rooster-ninja/moon-temp-tracer/CAD/ADS1115IDGSR/DGS0010A.stp

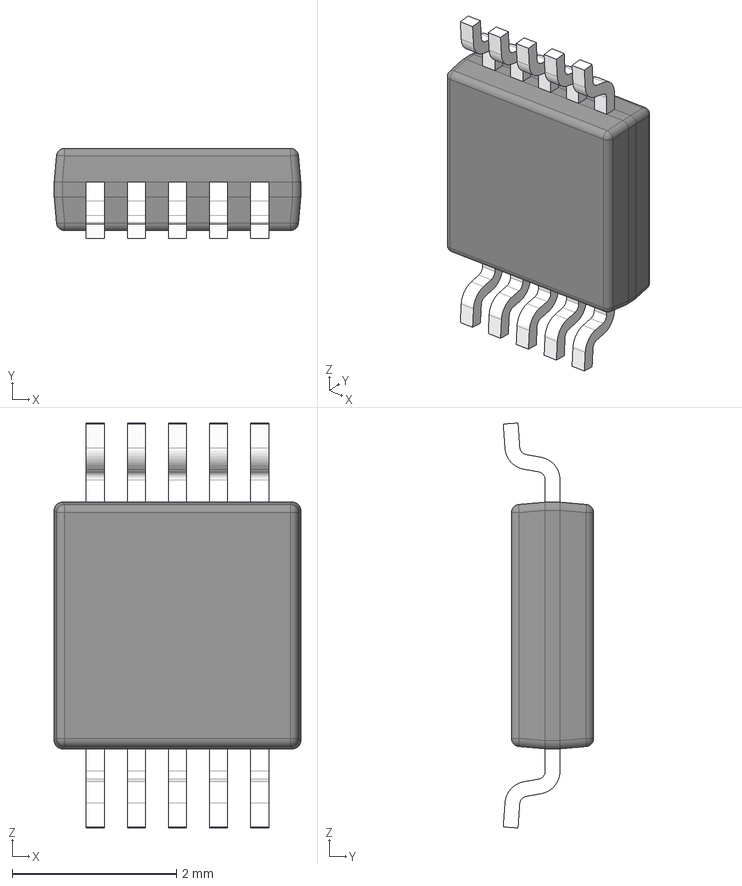
[picture p1: CAD file, 2026-07-23]
CAD/ADS1115IDGSR/DGS0010A.stp
3.00 x 1.10 x 4.93 mm
BODY-SO
LEAD-SO x 10
PIN1-ID
