rooster-ninja/moon-temp-tracer/CAD/KiCADv6/STP/CL05B104KP5VPNC.step

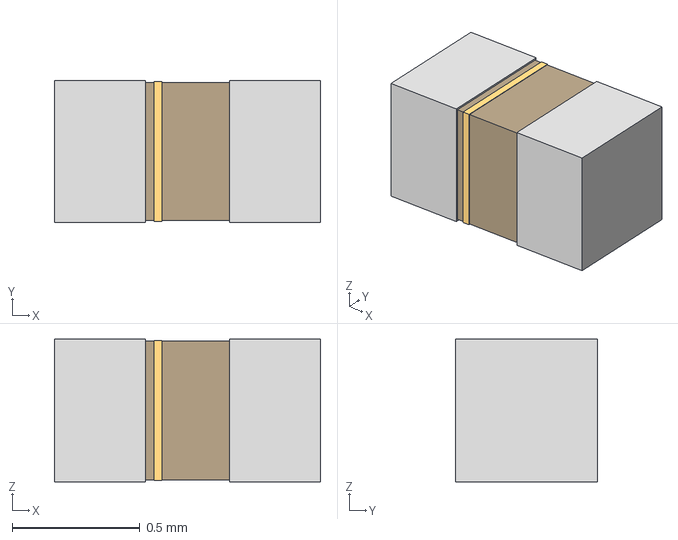
[picture p2: CAD file, 2026-07-25]
CAD/KiCADv6/STP/CL05B104KP5VPNC.step
1.04 x 0.558 x 0.559 mm
