rooster-ninja/moon-temp-tracer/CAD/RNCF0603TKY10K0/STA_RNCF0603_STP.step

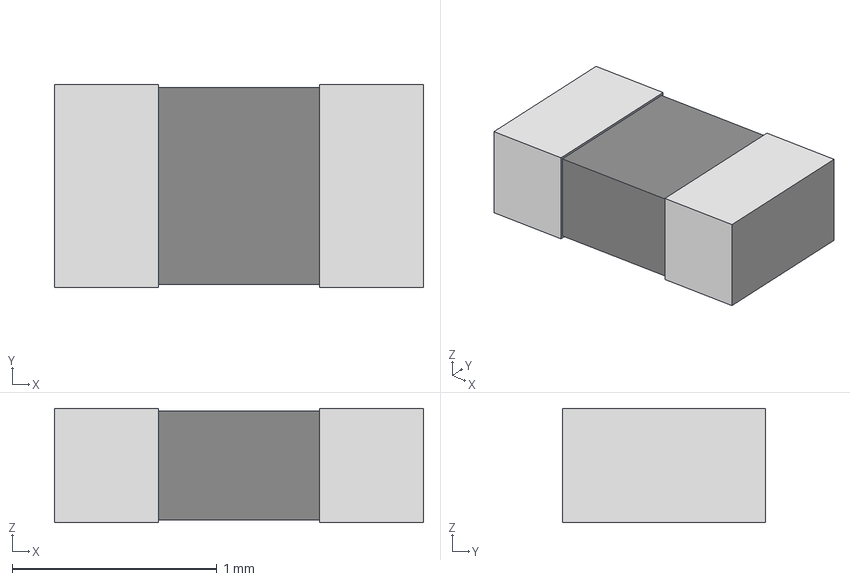
[picture p3: CAD file, 2026-07-23]
CAD/RNCF0603TKY10K0/STA_RNCF0603_STP.step
1.80 x 0.99 x 0.559 mm
