rooster-ninja/moon-temp-tracer/CAD/s861.stp

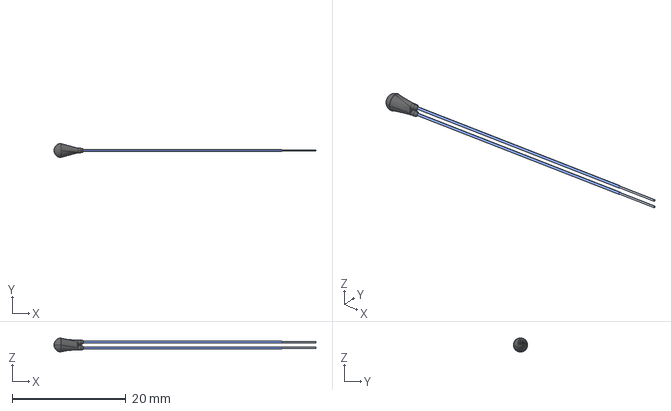
[picture p4: CAD file, 2026-07-23]
CAD/s861.stp
46.0 x 2.50 x 2.50 mm
