rooster-ninja/moon-temp-tracer/CAD/KiCADv6/STP/RC0402FR-074K7L.step

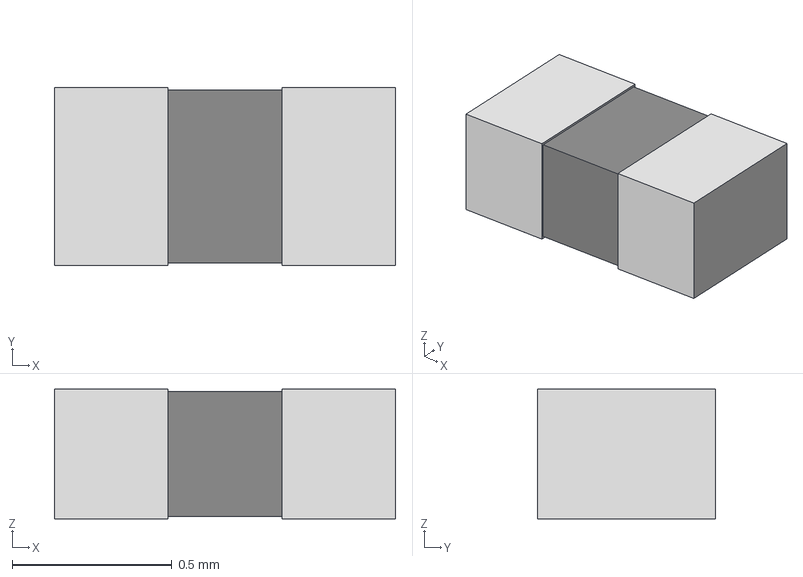
[picture p5: CAD file, 2026-07-25]
CAD/KiCADv6/STP/RC0402FR-074K7L.step
1.07 x 0.558 x 0.406 mm
