rooster-ninja/moon-temp-tracer/CAD/KiCADv6/STP/DBZ0003A.stp

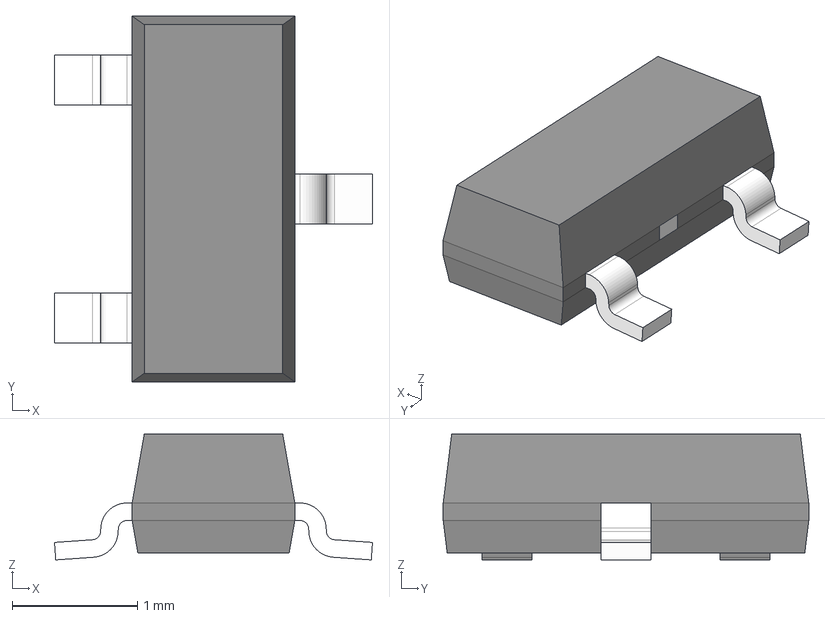
[picture p6: CAD file, 2026-07-25]
CAD/KiCADv6/STP/DBZ0003A.stp
2.54 x 2.92 x 1.01 mm
BODY-SOT
LEAD-SOT x 3
PIN1-ID
TIEBAR
