rooster-ninja/moon-temp-tracer/CAD/KiCADv6/STP/CAP_GRM155R60J106ME05D.step

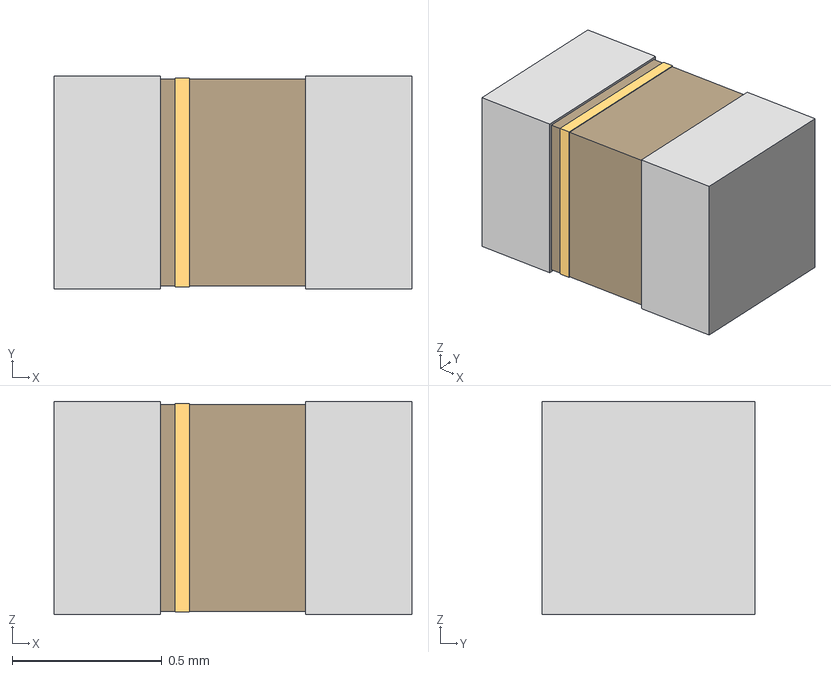
[picture p7: CAD file, 2026-07-23]
CAD/KiCADv6/STP/CAP_GRM155R60J106ME05D.step
1.19 x 0.712 x 0.711 mm
