rooster-ninja/moon-temp-tracer/CAD/Schematic/MillstoneDifferentialBridge.kicad_sch

## KiCad design CAD/Schematic/MillstoneDifferentialBridge.kicad_sch (2026-07-25)

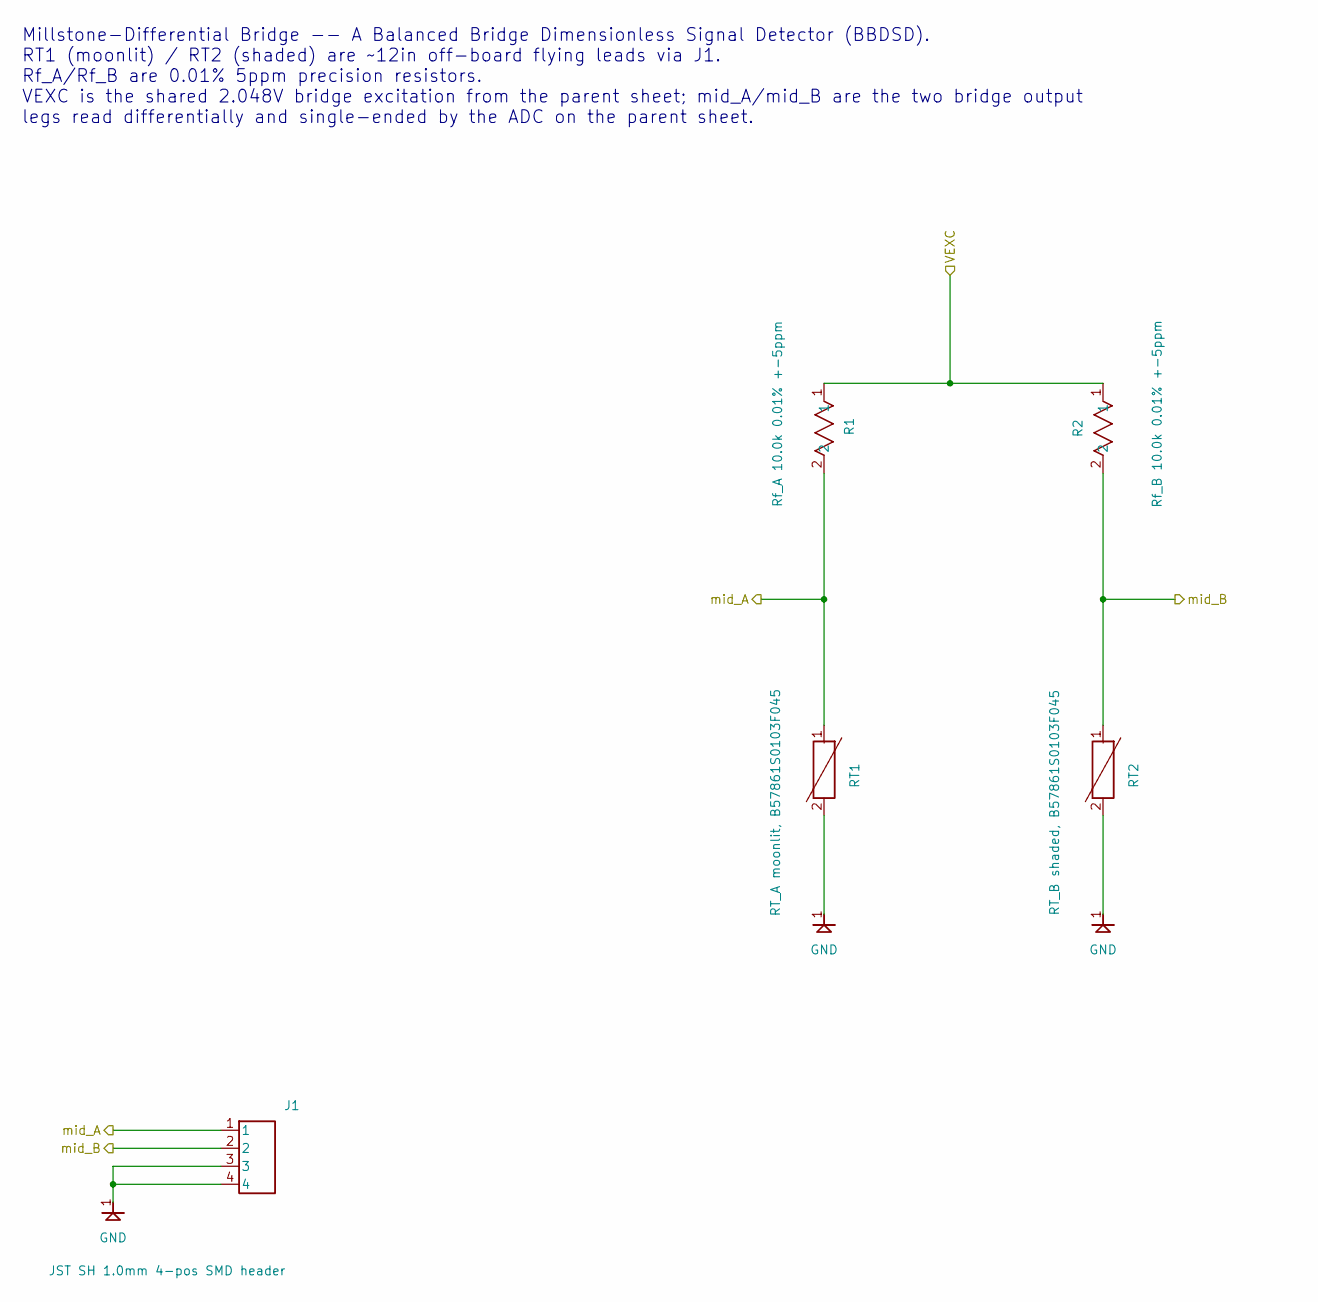
[picture p8: schematic MillstoneDifferentialBridge.kicad_sch]

Parts:
J1: JST SH 1.0mm 4-pos SMD header
R1: Rf_A 10.0k 0.01% +-5ppm; STA_RNCF0603_STP
R2: Rf_B 10.0k 0.01% +-5ppm; STA_RNCF0603_STP
RT1: RT_A moonlit, B57861S0103F045
RT2: RT_B shaded, B57861S0103F045

Connections:
GND: J1.3, J1.4, RT1.2, RT2.2
VEXC: R1.1, R2.1
mid_A: J1.1, R1.2, RT1.1
mid_B: J1.2, R2.2, RT2.1

Notes on the sheet:
Millstone-Differential Bridge -- A Balanced Bridge Dimensionless Signal Detector (BBDSD). RT1 (moonlit) / RT2 (shaded) are ~12in off-board flying leads via J1. Rf_A/Rf_B are 0.01% 5ppm precision resistors. VEXC is the shared 2.048V bridge excitation from the parent sheet; mid_A/mid_B are the two br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
