rooster-ninja/moon-temp-tracer/CAD/Schematic/SENSOR_MoonTempTracer.kicad_sch

## KiCad design CAD/Schematic/SENSOR_MoonTempTracer.kicad_sch (2026-07-25)

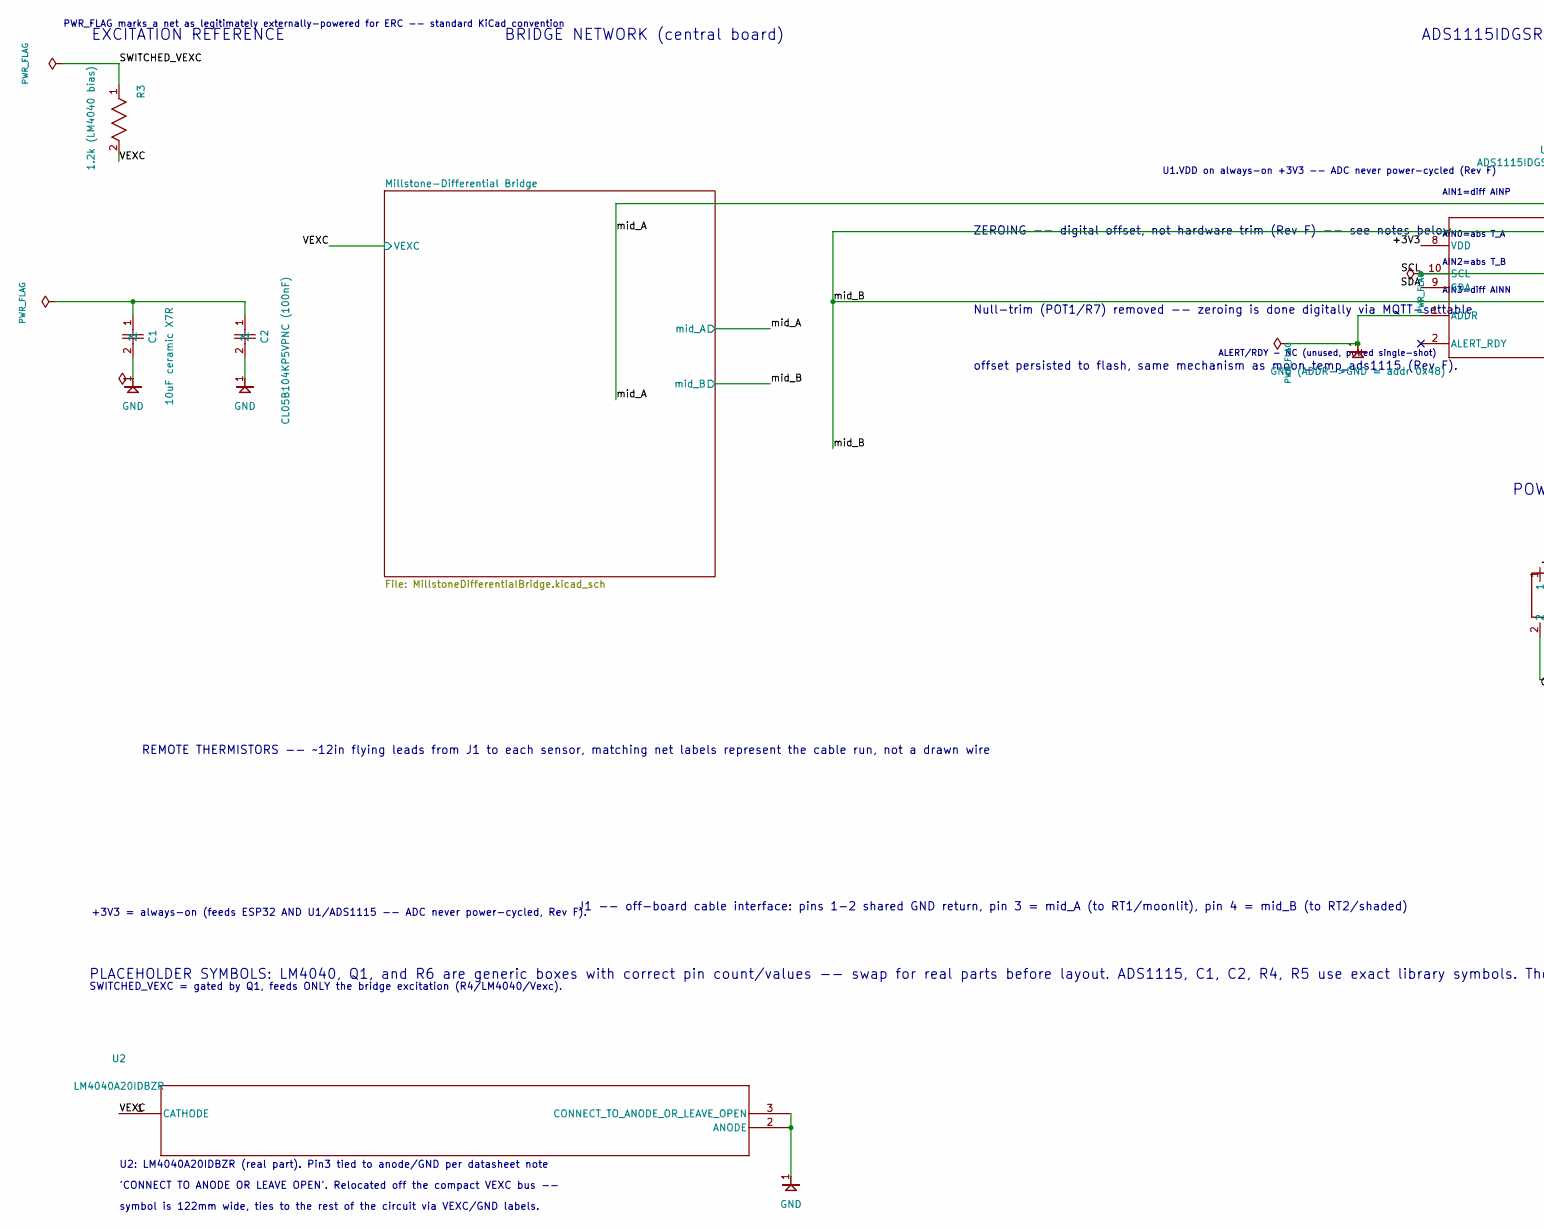
[picture p9: schematic SENSOR_MoonTempTracer.kicad_sch, part in row 1, column 1]

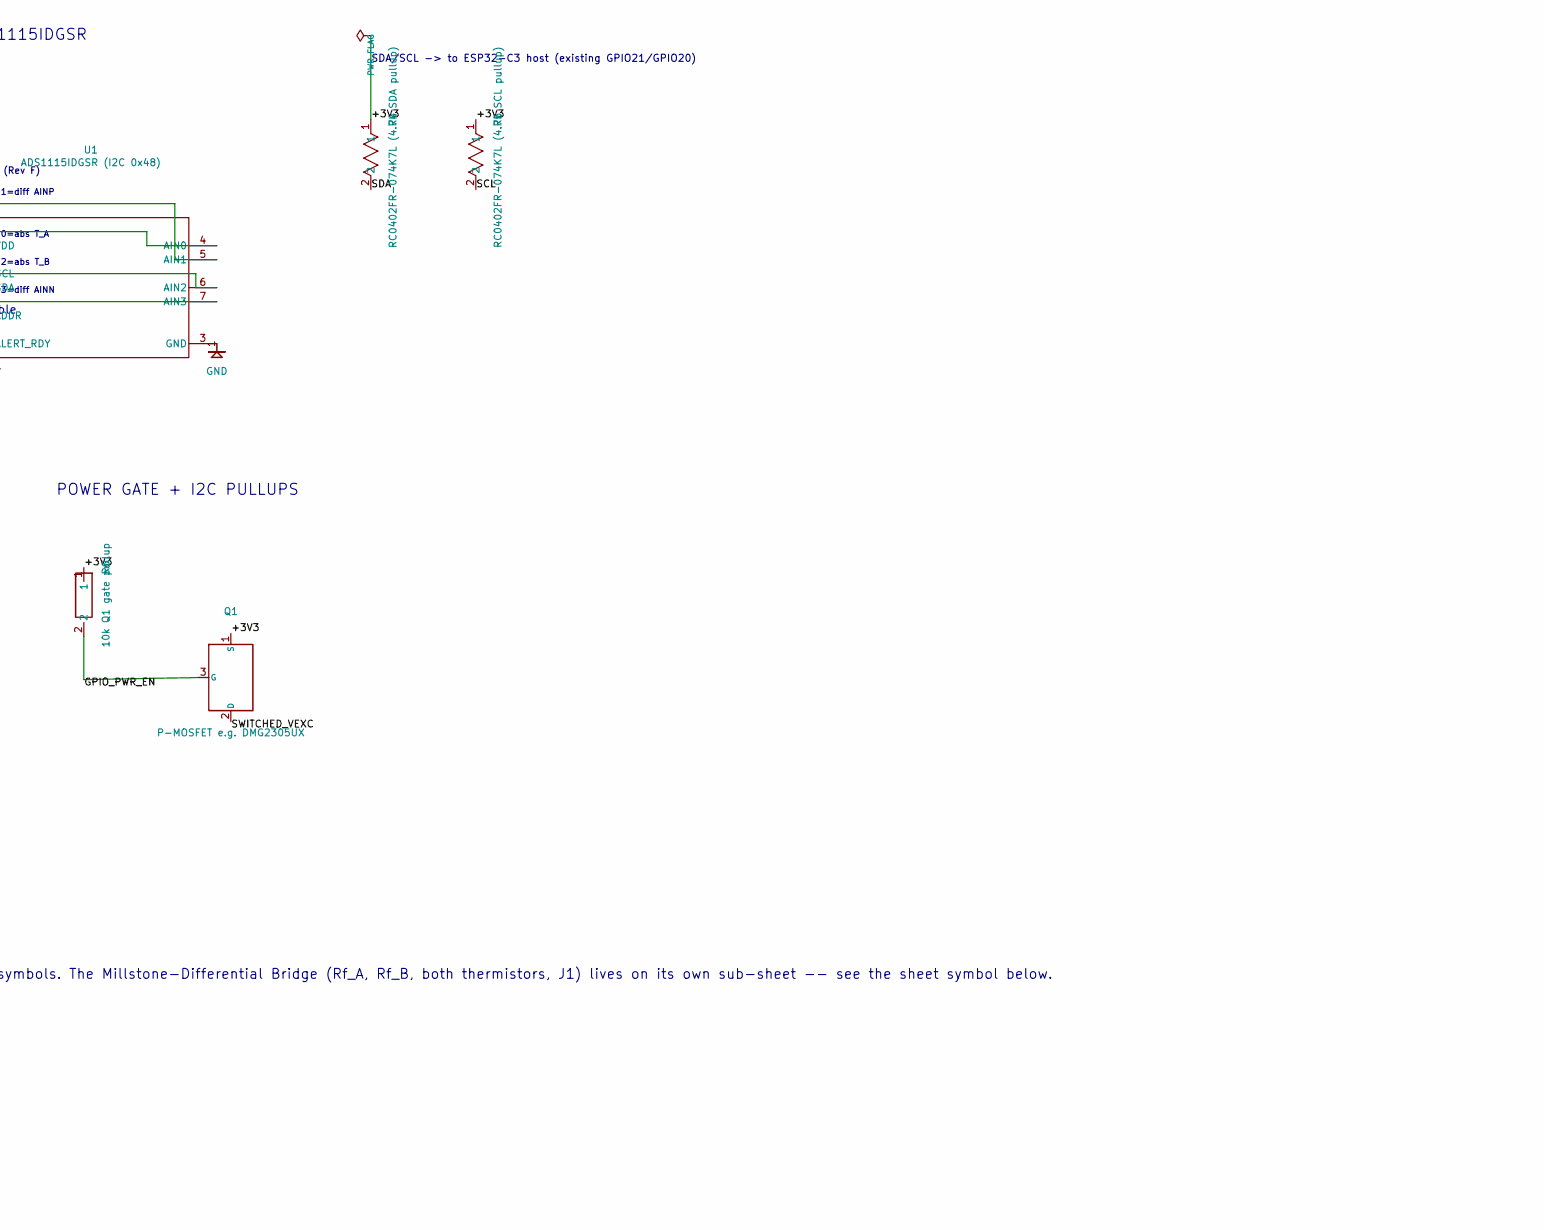
[picture p10: schematic SENSOR_MoonTempTracer.kicad_sch, part in row 1, column 2]

Parts:
C1: 10uF ceramic X7R; CAP_GRM155R60J106ME05D_MUR
C2: CL05B104KP5VPNC (100nF); CAP_0402_SAM
Q1: P-MOSFET e.g. DMG2305UX
R3: 1.2k (LM4040 bias)
R4: RC0402FR-074K7L (4.7k SDA pullup); YAG_R0402_YAG
R5: RC0402FR-074K7L (4.7k SCL pullup); YAG_R0402_YAG
R6: 10k Q1 gate pullup
U1: ADS1115IDGSR (I2C 0x48); DGS0010A_N
U2: LM4040A20IDBZR; DBZ3_TEX

Connections:
+3V3: Q1.1 (S), R4.1, R5.1, R6.1, U1.8 (VDD)
GND: C1.2, C2.2, U1.3 (GND), U2.2 (ANODE), U2.3 (CONNECT_TO_ANODE_OR_LEAVE_OPEN)
GND (ADDR->GND = addr 0x48): U1.1 (ADDR)
GPIO_PWR_EN: Q1.3 (G), R6.2
unnamed: C1.1, C2.1
SCL: R5.2, U1.6 (AIN2), U1.10 (SCL)
SDA: R4.2, U1.9 (SDA)
SWITCHED_VEXC: Q1.2 (D), R3.1
VEXC: R3.2, U2.1 (CATHODE)
mid_A: U1.5 (AIN1)
mid_B: U1.4 (AIN0), U1.7 (AIN3)

Notes on the sheet:
PLACEHOLDER SYMBOLS: LM4040, Q1, and R6 are generic boxes with correct pin count/values -- swap for real parts before layout. ADS1115, C1, C2, R4, R5 use exact library symbols. The Millstone-Differential Bridge (Rf_A, Rf_B, both thermistors, J1) lives on its own sub-sheet -- see the sheet symbol be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
AIN2=abs T_B
ZEROING -- digital offset, not hardware trim (Rev F) -- see notes below
REMOTE THERMISTORS -- ~12in flying leads from J1 to each sensor, matching net labels represent the cable run, not a drawn wire
AIN1=diff AINP
EXCITATION REFERENCE
J1 -- off-board cable interface: pins 1-2 shared GND return, pin 3 = mid_A (to RT1/moonlit), pin 4 = mid_B (to RT2/shaded)
AIN3=diff AINN
POWER GATE + I2C PULLUPS
ADS1115IDGSR
BRIDGE NETWORK (central board)
ALERT/RDY - NC (unused, polled single-shot)
SDA/SCL -> to ESP32-C3 host (existing GPIO21/GPIO20)
+3V3 = always-on (feeds ESP32 AND U1/ADS1115 -- ADC never power-cycled, Rev F).
Null-trim (POT1/R7) removed -- zeroing is done digitally via MQTT-settable
offset persisted to flash, same mechanism as moon_temp_ads1115 (Rev F).
U1.VDD on always-on +3V3 -- ADC never power-cycled (Rev F)
SWITCHED_VEXC = gated by Q1, feeds ONLY the bridge excitation (R4/LM4040/Vexc).
PWR_FLAG marks a net as legitimately externally-powered for ERC -- standard KiCad convention
U2: LM4040A20IDBZR (real part). Pin3 tied to anode/GND per datasheet note
'CONNECT TO ANODE OR LEAVE OPEN'. Relocated off the compact VEXC bus --
symbol is 122mm wide, ties to the rest of the circuit via VEXC/GND labels.
AIN0=abs T_A
