rooster-ninja/moon-temp-tracer/reticulum-bridge-code/bridge.py

import serial
import json
import threading
import time
import RNS

SERIAL_PORT = "/dev/ttyACM0"
BAUD = 115200

# Destination hash of the receiving Reticulum identity (Mac's hello.py, for now)
PEER_HASH_HEX = "d8560d80c4d1dbad237c08b95b711cc5"
APP_NAME = "helloworld"
ASPECT = "node"

# Downlink: the server addresses this destination to push Moon-tracking
# targets down to the gateway. Separate app/aspect from the uplink OUT
# destination above, since this is a distinct (inbound) destination.
DOWNLINK_APP_NAME = "moontracer"
DOWNLINK_ASPECT = "downlink"

serial_lock = threading.Lock()


def make_downlink_callback(ser):
    def on_downlink_packet(message, packet):
        text = message.decode("utf-8", errors="replace")
        try:
            data = json.loads(text)
            az = float(data["az"])
            alt = float(data["alt"])
        except (json.JSONDecodeError, KeyError, TypeError, ValueError):
            print(f"Malformed downlink packet, skipping: {text}")
            return

        cmd = f"SET:{az:.2f},{alt:.2f}\n"
        with serial_lock:
            ser.write(cmd.encode("utf-8"))
        print(f"Downlink -> gateway: {cmd.strip()}")

    return on_downlink_packet


def main():
    reticulum = RNS.Reticulum()

    identity_path = RNS.Reticulum.storagepath + "/bridge_identity"
    try:
        my_identity = RNS.Identity.from_file(identity_path)
        if my_identity is None:
            my_identity = RNS.Identity()
            my_identity.to_file(identity_path)
    except Exception:
        my_identity = RNS.Identity()
        my_identity.to_file(identity_path)

    peer_hash = bytes.fromhex(PEER_HASH_HEX)
    if not RNS.Transport.has_path(peer_hash):
        print("No path to peer yet, requesting...")
        RNS.Transport.request_path(peer_hash)
        time.sleep(3)

    peer_identity = RNS.Identity.recall(peer_hash)
    if not peer_identity:
        print("Could not recall peer identity. Is the peer announced?")
        return

    peer_dest = RNS.Destination(
        peer_identity, RNS.Destination.OUT, RNS.Destination.SINGLE,
        APP_NAME, ASPECT
    )

    ser = serial.Serial(SERIAL_PORT, BAUD, timeout=1)

    # IN destination the server addresses to send downlink targets to this
    # bridge. RNS packet delivery runs on its own thread, so serial writes
    # from the callback are serialized against the uplink read loop below
    # via serial_lock.
    downlink_dest = RNS.Destination(
        my_identity, RNS.Destination.IN, RNS.Destination.SINGLE,
        DOWNLINK_APP_NAME, DOWNLINK_ASPECT
    )
    downlink_dest.set_proof_strategy(RNS.Destination.PROVE_ALL)
    downlink_dest.set_packet_callback(make_downlink_callback(ser))
    downlink_dest.announce()
    print(f"Downlink destination: {RNS.prettyhexrep(downlink_dest.hash)}")

    print(f"Bridge listening on {SERIAL_PORT}, forwarding to peer...")

    while True:
        with serial_lock:
            line = ser.readline().decode("utf-8", errors="replace").strip()
        if not line:
            continue
        if line.startswith("RNS:"):
            payload = line[4:]
            try:
                data = json.loads(payload)
                text = json.dumps(data)
                RNS.Packet(peer_dest, text.encode("utf-8")).send()
                print(f"Forwarded to Reticulum: {text}")
            except json.JSONDecodeError:
                print(f"Malformed RNS line, skipping: {payload}")
        else:
            print(line)

if __name__ == "__main__":
    main()
