rooster-ninja/moon-temp-tracer/(commit log)

2026-07-23 Initial commit: Wheatstone-bridge thermal sensor circuit (Rev D)
    ADS1115IDGSR differential bridge sensor design with LM4040 excitation,
    power-gated sensor boards, and real sourced parts (RNCF0603TKY10K0,
    B57861S0103F045). Includes schematic, design notes, reference datasheets,
    and in-progress KiCad PCB layout.
    Claude-Session: https://claude.ai/code/session_01BbEX6hxNqq8y29X9R6AS4t
    [CAP_GRM155R60J106ME05D_MUR.step, DGS0010A.stp, SENSOR_MoonTempTracer.kicad_pcb, SENSOR_MoonTempTracer.kicad_sch, STA_RNCF0603_STP.step, s861.stp]
2026-07-24 Rev F: Millstone-Differential Bridge (BBDSD) — digital zeroing, split power domains
    Renames the circuit to Millstone-Differential Bridge, tagline "A Balanced
    Bridge Dimensionless Signal Detector" (BBDSD). Removes the physical POT1/R7
    null-trim in favor of digital zero-offset (same MQTT/flash mechanism as
    moon_temp_ads1115). Splits power domains: ADS1115 moves to the always-on
    +3V3 rail so it's never power-cycled, while the MOSFET now gates only the
    bridge excitation path (SWITCHED_VEXC) — isolates read-timing accuracy to
    just the bridge's own RC settling, no ADC startup uncertainty.
    Also includes KiCad project files populated by opening in KiCad (10.0.5),
    the ERC report, and a new web s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
    [SENSOR_MoonTempTracer.kicad_sch]
2026-07-25 Split Millstone-Differential Bridge into its own hierarchical sheet, add custom title block with Goose logo
    The bridge (Rf_A, Rf_B, both thermistors, J1 connector) now lives on its
    own sub-sheet (MillstoneDifferentialBridge.kicad_sch), connected to the
    main board via VEXC/mid_A/mid_B hierarchical pins so it reads as the
    centerpiece of the design rather than blending into the supporting ADC/
    reference/power-gating circuitry. J1's pinout was reassigned so GND
    lands on pins 3-4 and the bridge midpoints on pins 1-2.
    Also adds a custom page layout (moon_temp_tracer.kicad_wks) with the
    Goose logo and wordmark in the title block, and folds in the real
    part symbols/footprints (LM4040A20IDBZR, RC040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
    [CAP_GRM155R60J106ME05D.step, CL05B104KP5VPNC.step, DBZ0003A.stp, MillstoneDifferentialBridge.kicad_sch, RC0402FR-074K7L.step, RC0402JR-071K2L.step, SENSOR_MoonTempTracer.kicad_pcb, SENSOR_MoonTempTracer.kicad_sch]
2026-09-23 Add LoRa frame protocol firmware: fixed-size frames, source IDs, stable end-to-end
    [main.cpp]
2026-09-25 Add Claude Code handoff doc for LoRa + Reticulum comms work
    Captures repo layout, hosts, radio pinout/params, frame protocol,
    bridge design decisions, next steps, and known open issues so future
    sessions can pick up the tracker/comms work without re-deriving state.
    Claude-Session: https://claude.ai/code/session_018T45h1bksnG6cXeBx8Zaju
2026-09-25 Add real moon-tracking downlink path (server -> bridge -> gateway)
    - moon_calc.py: computes topocentric Moon az/alt via pyephem for a given
    lat/lon (no ephemeris file download needed, matters for a
    possibly-offline Pi/server).
    - moon_downlink_daemon.py: runs on the server, computes az/alt on a
    configurable cadence and pushes it to bridge.py over Reticulum. Clamps
    to the mount's real limits (0-90 elevation, 180 degree azimuth arc):
    below the horizon it "co-planar parks" at alt=0 while still tracking
    true azimuth (when reachable), so the mount is pre-aimed for moonrise.
    - bridge.py: adds an IN destination so the server can actually address
    and send to it (previously only had an O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
2026-09-25 Scaffold field-node stepper conversion, defer real driving to TODO.md
    setTarget() now clamps against calibrated (currently placeholder) field
    limits and converts az/alt degrees to step counts, handing off to a
    moveStepperTo() stub. Real values (steps/degree, home offsets, homed
    limits) and the actual driver call land once the stepper hardware and
    homing routine exist - tracked in TODO.md rather than guessed now.
2026-09-25 Add path-wait robustness and real delivery confirmation to downlink daemon
    Bench testing showed the daemon printing "Sent target..." on every cycle
    with zero corresponding trace on the Pi's bridge.py, across multiple
    stable-connection retries. Root cause: the daemon only checked has_path()
    once, then blindly slept 3s and proceeded regardless of whether the path
    request ever resolved - Identity.recall() succeeding just means the
    identity's public key is cached, not that a route exists. Packet.send()
    doesn't raise even with no route, so failed sends were completely silent
    on both ends.
    Now polls has_path() for up to 10s instead of a fixed sleep, bails out
    with a clear message if it never reso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
    [moon_downlink_daemon.py]
2026-09-25 Role-gate handleFrame() to stop gateway/field nodes acting on self-echoed frames
    Bench testing showed the gateway hearing its own transmitted
    STEPPER_CONTROL/DATA_REQUEST bounce back (RF self-reception) and, since
    handleFrame() had no role awareness, processing them as if they were real
    peer traffic: running setTarget()/moveStepperTo() on itself and ACKing
    its own command. This was actively blocking downlink verification - the
    self-echo consistently won the gateway's single receive slot, so a real
    reply from the field node (which has actual propagation + processing
    delay) had no chance to land in the same cycle.
    STEPPER_CONTROL and DATA_REQUEST are only ever sent by the gateway;
    DATA_RESPON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
    [main.cpp]
2026-09-25 Update docs with confirmed downlink status and real install coordinates
    Bench-tested the full downlink path end to end tonight (server ephemeris
    -> Reticulum -> bridge -> gateway serial -> LoRa STEPPER_CONTROL -> field
    node -> ACK back), fixing two real bugs along the way: silent send
    failures in moon_downlink_daemon.py (no path/delivery confirmation) and a
    missing role gate in handleFrame() that let the gateway act on its own
    RF self-echoed frames. Records the real install coordinates
    (50.33805, -113.71220) and updates CLAUDE.md/TODO.md/downlink_setup.md
    to reflect what's now confirmed working vs. still open.
    Claude-Session: https://c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
2026-09-29 Add deb-serv-incus Reticulum node and a LoRa range test tool
    Server side: server_node.py is a non-interactive, production replacement
    for the bench hello.py stand-in - announces the uplink IN destination,
    logs every received reading to console and CSV, meant to run
    continuously (systemd unit template included). docs/downlink_setup.md
    gets a new section 0 walking through the real deb-serv-incus setup
    (TCP interface config, running server_node.py, pointing bridge.py's
    PEER_HASH_HEX at it) that mirrors the Mac stand-in setup already proven
    working in bench testing.
    Range test: adds RANGE_PING/RANGE_PONG frame types (0x06/0x07) to
    main.cpp. Not role-gated - whichever node gets pinged pongs back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
    [main.cpp, range_test.py, server_node.py]
2026-09-29 Fix flickering loss% in range test live status line
    Real hardware test showed loss% bouncing between 0% and a transient
    value every cycle (e.g. 0% -> 50% -> 0% -> 33% -> 0%...) even with
    zero actual packet loss. Cause: the status line refreshed on both the
    ping send and the pong/miss resolution, so it briefly showed the
    "still waiting on this one" state as if it were settled loss. Now only
    updates on OK/MISS, once the round trip has actually resolved.
    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
    [range_test.py]
2026-09-29 Add Reticulum forwarding for range test results, update docs after first hardware run
    First real-hardware range test run confirmed the ping/pong mechanism
    works (0% loss, RSSI -38/-38 dBm, SNR 13.5/13.5 dB at close range) and
    surfaced a display bug in range_test.py's live status line (fixed in the
    previous commit). This commit adds the ability to watch a test remotely:
    - reticulum-bridge-code/range_test_monitor.py: a live receiver for range
    test results forwarded over Reticulum, meant to run on deb-serv-incus
    (or anywhere) alongside server_node.py. Same status-line view as the
    local tool, plus its own CSV log.
    - range_test.py gains an optional --reticulum-dest flag: when given, it
    f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
    [range_test.py, range_test_monitor.py]
2026-09-29 Fix range test giving false OK results with the field node unplugged
    Real-hardware test found the gateway reporting a perfect link (0% loss,
    7500+ pings) with the field node completely disconnected. Cause:
    RANGE_PING/RANGE_PONG handling is deliberately not role-gated (either
    node should be able to answer a ping), so the gateway's own RF-self-
    echoed ping (the same self-reception behavior documented elsewhere in
    this project) was getting answered by itself - self-heard ping -> self
    pong -> self-heard pong -> matching seq -> false RANGE OK, entirely
    independent of whether a real field node exists.
    Fixed by ignoring any RANGE_PING/RANGE_PONG whose sourceId equals the
    receiving node's own NODE_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
    [main.cpp]
